arachnidlabs/minimatrix/schematics/minimatrix-render-front.png

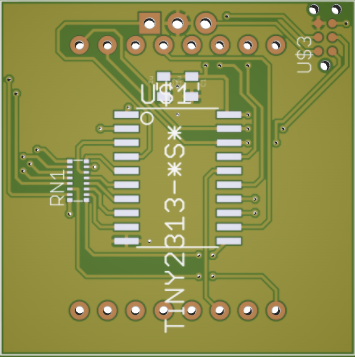
schematics/minimatrix-render-front.png
