arachnidlabs/minimatrix/schematics/minimatrix-render-back.png

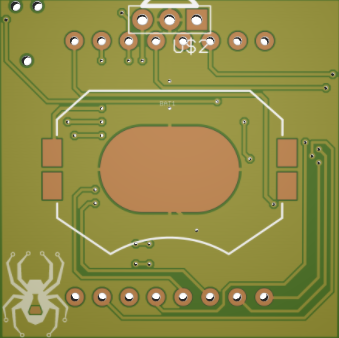
schematics/minimatrix-render-back.png
