arachnidlabs/minimatrix/README.Markdown

# Minimatrix

Minimatrix is a teeny little backpack for 3cm monocolor LED matrixes. It plays animations, and is reprogrammable via your computer monitor!
