arachnidlabs/minimatrix/schematics/minimatrix-layout.png

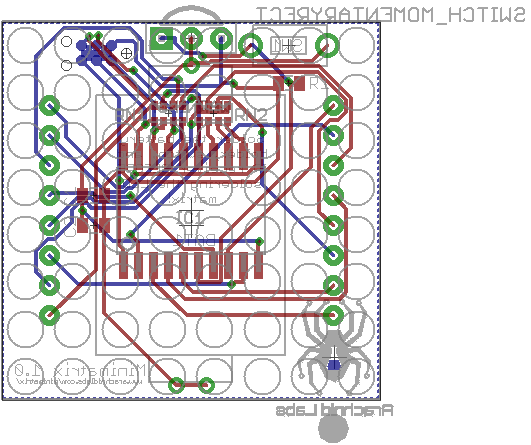
schematics/minimatrix-layout.png
