arachnidlabs/minimatrix/schematics/minimatrix-schematic.png

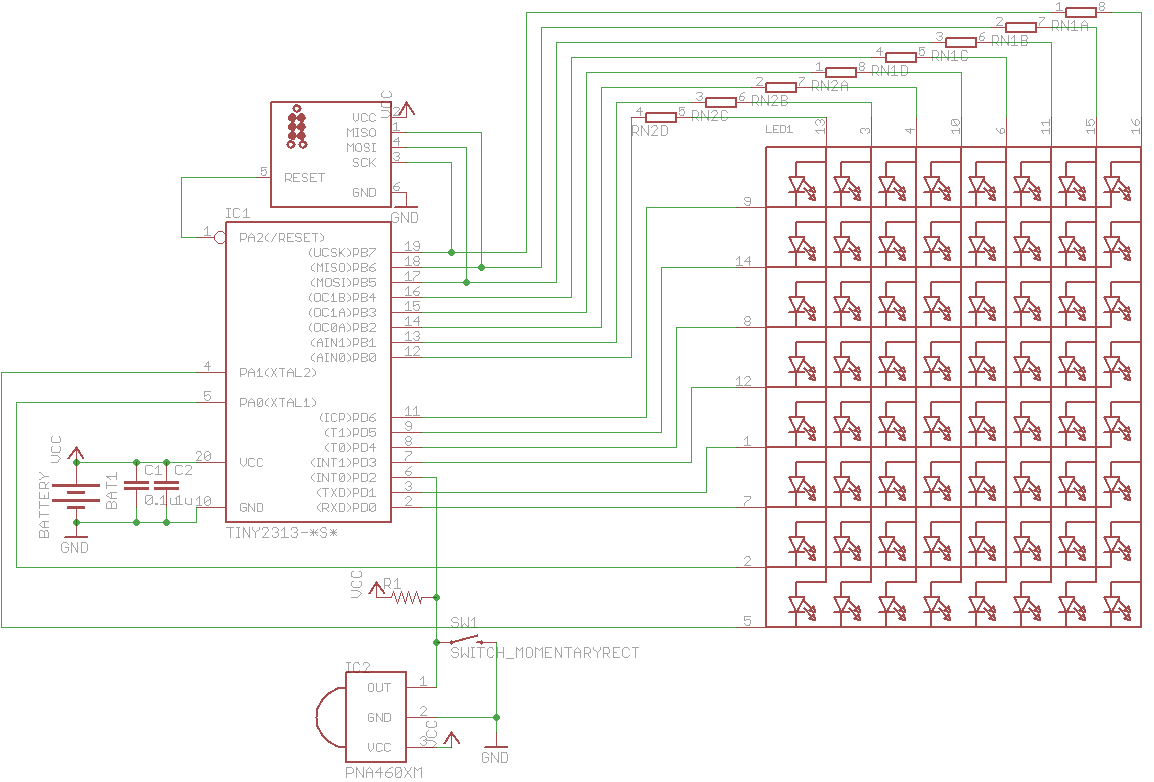
schematics/minimatrix-schematic.png
