arachnidlabs/minimatrix/schematics/pogojig-main.dxf

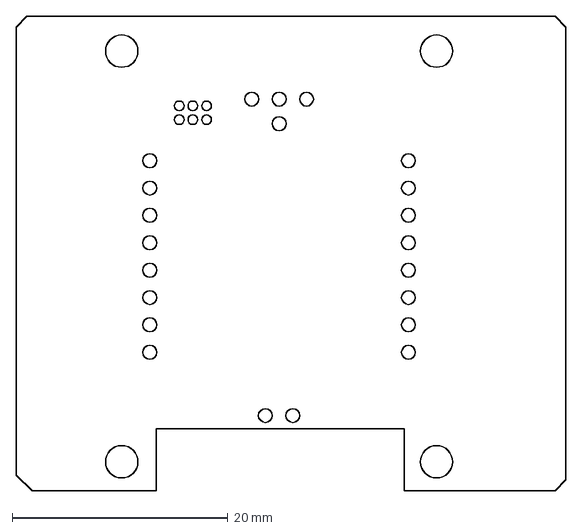
[picture p5: CAD file, 2013-07-08]
schematics/pogojig-main.dxf
51.0 x 44.0 mm
