arachnidlabs/minimatrix/schematics/pogojig.dxf

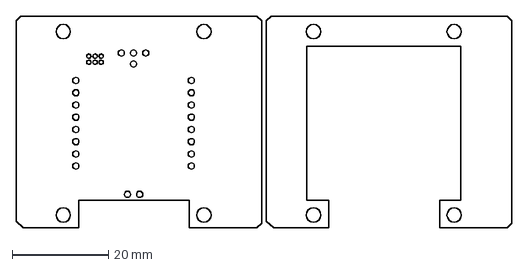
[picture p6: CAD file, 2013-07-08]
schematics/pogojig.dxf
103.0 x 44.0 mm
