arachnidlabs/minimatrix/(list of files, drawings)

Other design files:
schematics/pogojig.dsn
