arachnidlabs/minimatrix/schematics/pogojig.brd

## EAGLE design schematics/pogojig.brd (2013-07-08)

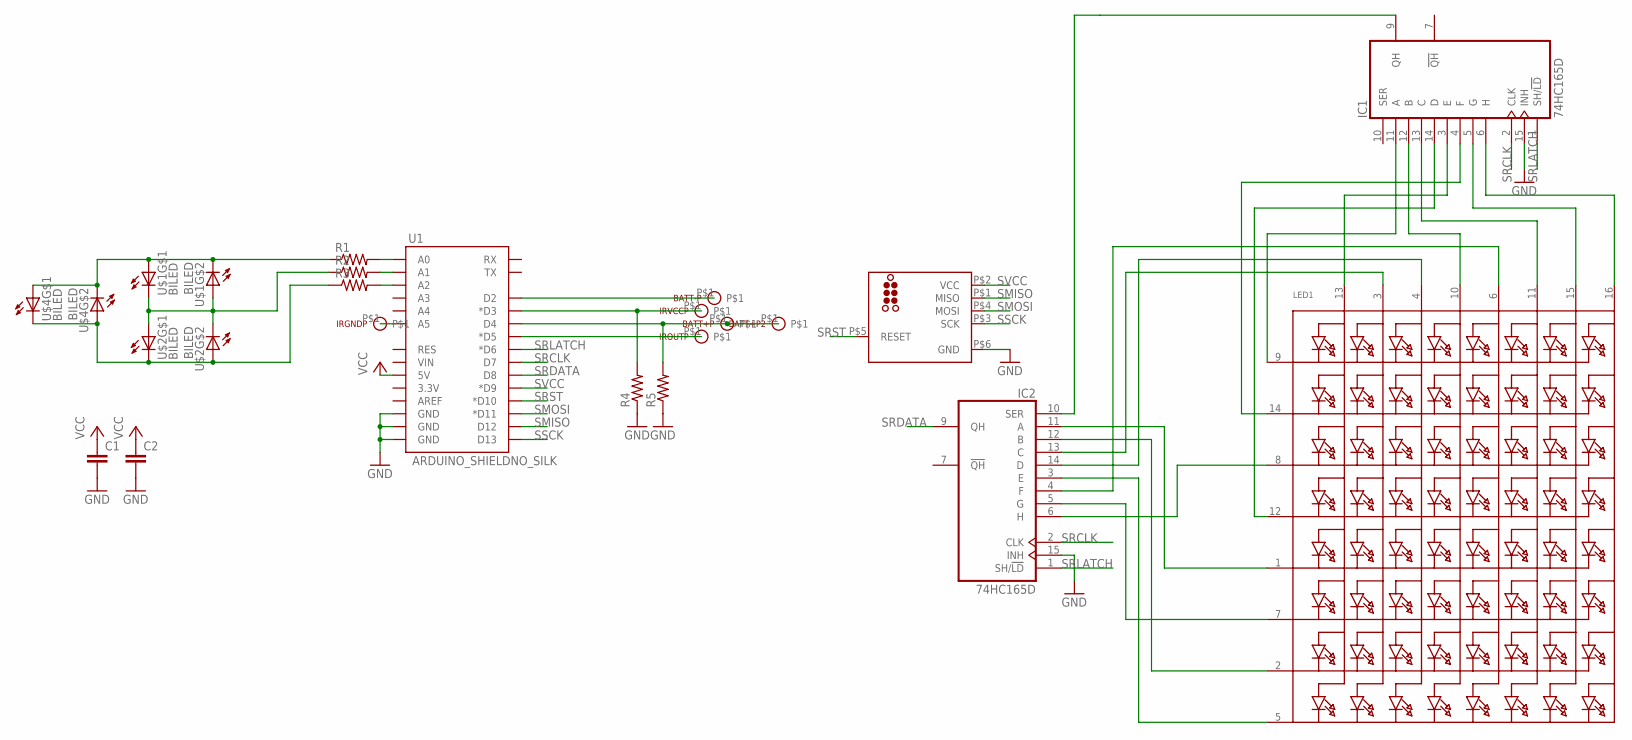
[picture p7: schematic pogojig.sch]

Parts:
BATT+P, BATT+P2: POGOPIN1.02; POGOPIN-1.02
BATT-P: POGOPIN1.02; POGOPIN-1.02
C1, C2: CAP0805; 0805
IC1, IC2: 74HC165D; SO16
IRGNDP: POGOPIN1.02; POGOPIN-1.02
IROUTP: POGOPIN1.02; POGOPIN-1.02
IRVCCP: POGOPIN1.02; POGOPIN-1.02
LED1: SEGMENT_8X8_ROWCATHODE; SEGMENT-30MM-POGO
R1, R2, R3, R4, R5: RESISTOR0805-RES; 0805
U1: ARDUINO_SHIELDNO_SILK; DUEMILANOVE_VIAS
U$1, U$2, U$4: BILED
U$3: TC2030_AVR; TC2030-MCP-NL-POGO

Connections:
GND: C1.2, C2.2, IC1.8 (GND), IC1.15 (INH), IC2.8 (GND), IC2.15 (INH), R4.1, R5.1, U1.GND@0 (GND), U1.GND@1 (GND), U1.GND@2 (GND), U$3.P$6 (GND)
unnamed: IC2.11 (A), LED1.1 (K5)
unnamed: IC2.12 (B), LED1.2 (K7)
unnamed: IC2.13 (C), LED1.3 (A2)
unnamed: IC2.14 (D), LED1.4 (A3)
unnamed: IC2.3 (E), LED1.5 (K8)
unnamed: IC2.4 (F), LED1.6 (A5)
unnamed: IC1.14 (D), LED1.12 (K4)
unnamed: IC2.5 (G), LED1.7 (K6)
unnamed: IC2.6 (H), LED1.8 (K3)
unnamed: IC1.11 (A), LED1.9 (K1)
unnamed: IC1.12 (B), LED1.10 (A4)
unnamed: IC1.13 (C), LED1.11 (A6)
unnamed: IC1.3 (E), LED1.13 (A1)
unnamed: IC1.4 (F), LED1.14 (K2)
unnamed: IC1.5 (G), LED1.15 (A7)
unnamed: IC1.6 (H), LED1.16 (A8)
unnamed: IC1.9 (QH), IC2.10 (SER)
unnamed: IRGNDP.P$1, U1.A5
unnamed: BATT+P.P$1, BATT+P2.P$1, R5.2, U1.D4
unnamed: BATT-P.P$1, U1.D2
unnamed: IRVCCP.P$1, R4.2, U1.D3 (*D3)
unnamed: IROUTP.P$1, U1.D5 (*D5)
unnamed: R3.2, U1.A2
unnamed: R2.2, U1.A1
unnamed: R1.2, U1.A0
unnamed: R3.1, U$2.A2 (A), U$2.C1 (C), U$4.A2 (A), U$4.C1 (C)
unnamed: R1.1, U$1.A1 (A), U$1.C2 (C), U$4.A1 (A), U$4.C2 (C)
unnamed: R2.1, U$1.A2 (A), U$1.C1 (C), U$2.A1 (A), U$2.C2 (C)
SMISO: U1.D12, U$3.P$1 (MISO)
SMOSI: U1.D11 (*D11), U$3.P$4 (MOSI)
SRCLK: IC1.2 (CLK), IC2.2 (CLK), U1.D7
SRDATA: IC2.9 (QH), U1.D8
SRLATCH: IC1.1 (SH/!LD), IC2.1 (SH/!LD), U1.D6 (*D6)
SRST: U1.D10 (*D10), U$3.P$5 (RESET)
SSCK: U1.D13, U$3.P$3 (SCK)
SVCC: U1.D9 (*D9), U$3.P$2 (VCC)
VCC: C1.1, C2.1, IC1.16 (VCC), IC2.16 (VCC), U1.5V

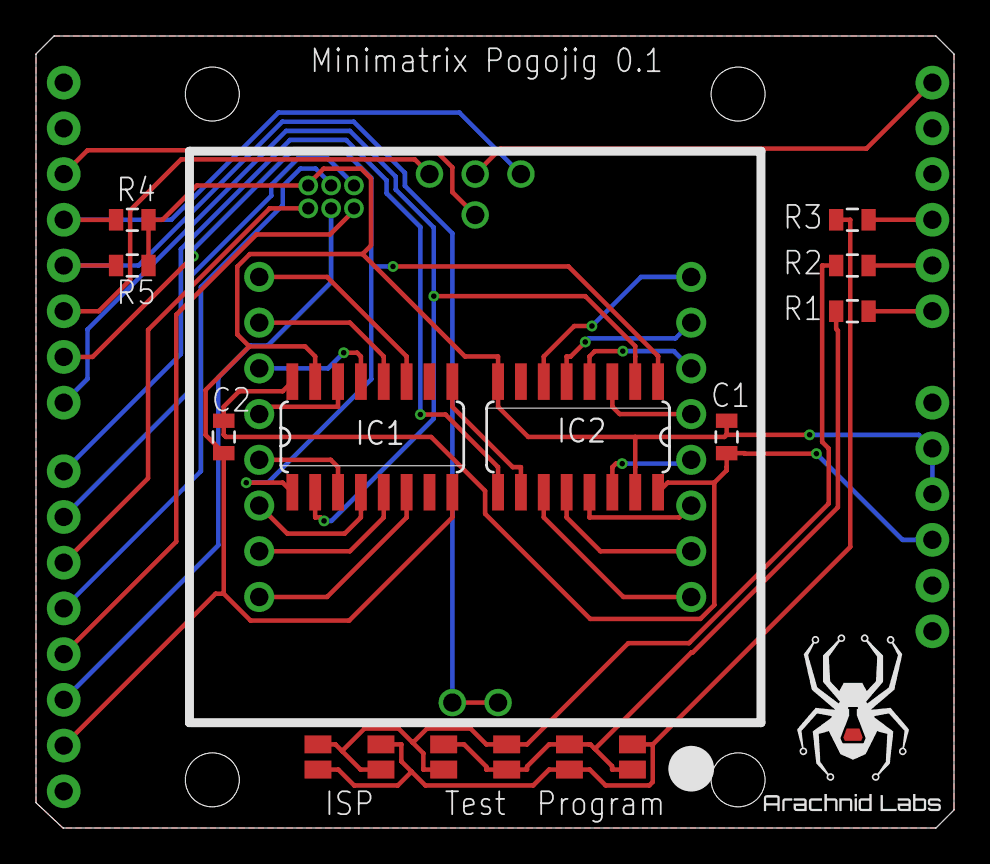
[picture p8: board pogojig.brd from above]

Board: 2 copper layers, 51.0 x 44.0 mm, 22 parts (1 on the bottom side), 38 nets.

Other parts of the board:
U$5: ARACHNID_LABS_LOGO_SM
