arachnidlabs/minimatrix/schematics/minimatrix.brd

## EAGLE design schematics/minimatrix.brd (2013-07-07)

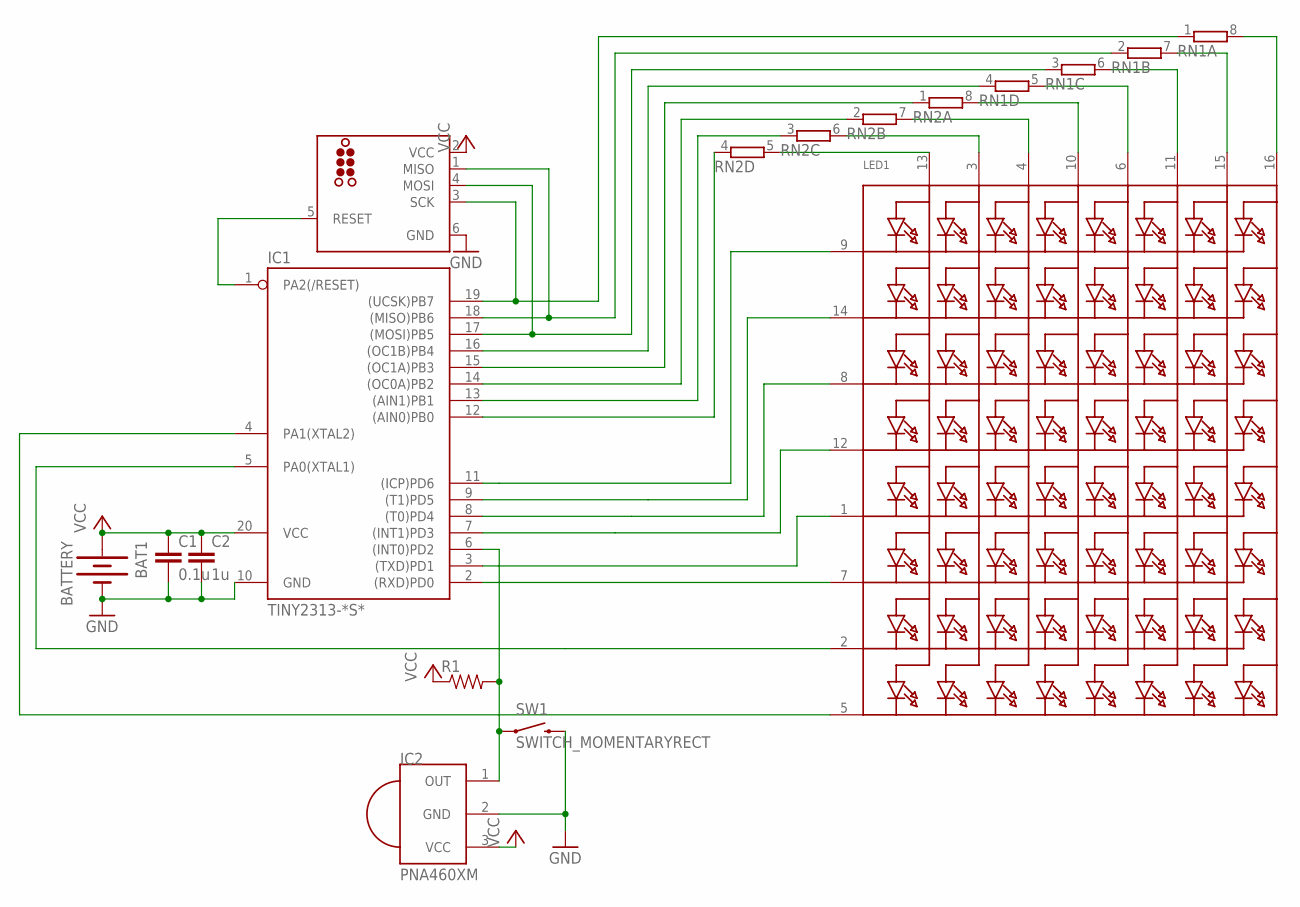
[picture p9: schematic minimatrix.sch]

Parts:
BAT1: BATTERY; COINCELL_PTH
C1: 0.1u; 0805
C2: 1u; 0805
IC1: TINY2313-*S*; SO20L$
IC2: PNA460XM
LED1: SEGMENT_8X8_ROWCATHODEM12A881UR; SEGMENT_BL-M12A881UR
R1: RESISTOR0805-RES; 0805
RN1, RN2: 4R-NCAY16; CAY16
SW1: SWITCH_MOMENTARYRECT; SWITCH_MOMENTARY_RECT
U$3: TC2030_AVRMCP-NL; TC2030-MCP-NL

Connections:
C2: IC1.13 ((AIN1)PB1), RN2.3 (1)
C3: IC1.14 ((OC0A)PB2), RN2.2 (1)
C4: IC1.15 ((OC1A)PB3), RN2.1
C5: IC1.16 ((OC1B)PB4), RN1.4 (1)
COL1: IC1.12 ((AIN0)PB0), RN2.4 (1)
GND: BAT1.NEG (-), C1.2, C2.2, IC1.10 (GND), IC2.2 (GND), SW1.P$2 (2), U$3.6 (GND)
MISO: IC1.18 ((MISO)PB6), RN1.2 (1), U$3.1 (MISO)
MOSI: IC1.17 ((MOSI)PB5), RN1.3 (1), U$3.4 (MOSI)
unnamed: IC1.2 ((RXD)PD0), LED1.7 (K6)
unnamed: LED1.3 (A2), RN2.6 (2)
unnamed: LED1.4 (A3), RN2.7 (2)
unnamed: LED1.10 (A4), RN2.8 (2)
unnamed: LED1.6 (A5), RN1.5 (2)
unnamed: LED1.11 (A6), RN1.6 (2)
unnamed: LED1.15 (A7), RN1.7 (2)
unnamed: LED1.16 (A8), RN1.8 (2)
unnamed: LED1.13 (A1), RN2.5 (2)
unnamed: IC1.3 ((TXD)PD1), LED1.1 (K5)
unnamed: IC1.4 (PA1(XTAL2)), LED1.5 (K8)
unnamed: IC1.6 ((INT0)PD2), IC2.1 (OUT), R1.2, SW1.P$1 (1)
R2: IC1.9 ((T1)PD5), LED1.14 (K2)
R3: IC1.8 ((T0)PD4), LED1.8 (K3)
R4: IC1.7 ((INT1)PD3), LED1.12 (K4)
R7: IC1.5 (PA0(XTAL1)), LED1.2 (K7)
RESET: IC1.1 (PA2(/RESET)), U$3.5 (RESET)
ROW1: IC1.11 ((ICP)PD6), LED1.9 (K1)
SCK: IC1.19 ((UCSK)PB7), RN1.1, U$3.3 (SCK)
VCC: BAT1.POS1 (+), BAT1.POS2 (+), C1.1, C2.1, IC1.20 (VCC), IC2.3 (VCC), R1.1, U$3.2 (VCC)

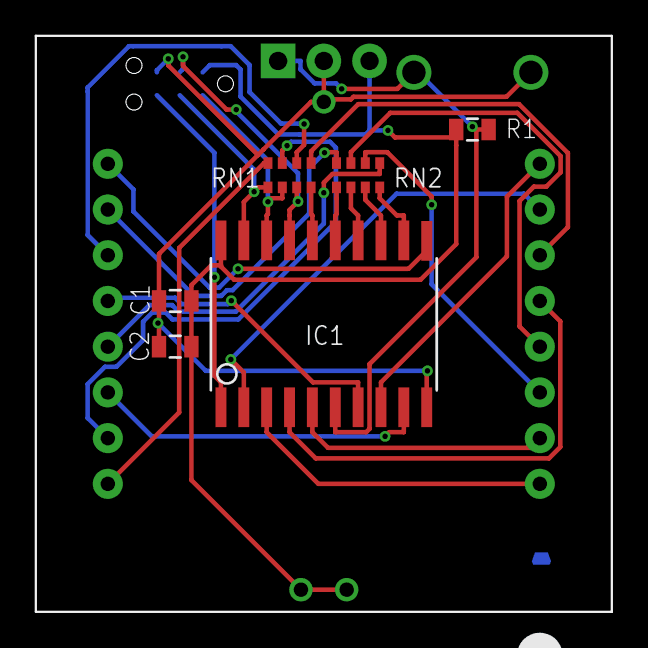
[picture p10: board minimatrix.brd from above]

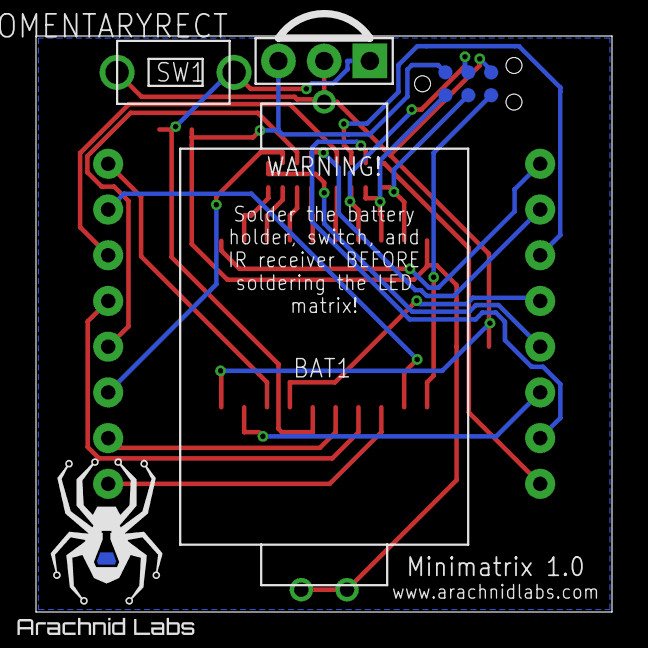
[picture p11: board minimatrix.brd from below]

Board: 2 copper layers, 32.0 x 32.0 mm, 12 parts (5 on the bottom side), 28 nets.

Other parts of the board:
U$4: ARACHNID_LABS_LOGO_SM
