arachnidlabs/minimatrix/firmware/src/hardware.h

#define COLUMN_PORT PORTB
#define COLUMN_DDR DDRB
#define PORTD_ROWS (_BV(PD6) | _BV(PD5) | _BV(PD4) | _BV(PD3) | _BV(PD1) | _BV(PD0))
#define PORTA_ROWS (_BV(PA1) | _BV(PA0))
#define IR_PIN PD2
