arachnidlabs/minimatrix/firmware/src/glcdfont.c

#include <avr/io.h>
#include <avr/pgmspace.h> 

#include "glcdfont.h"
 
// standard ascii 5x7 font

unsigned const char font[] PROGMEM = {
     0x7C,  0x54,  0x6C,  0x54,  0x7C,  
     0x7C,  0xDA,  0xF2,  0xDA,  0x7C,  
     0x7C,  0xD6,  0xF2,  0xD6,  0x7C,  
     0x38,  0x7C,  0x3E,  0x7C,  0x38,  
     0x18,  0x3C,  0x7E,  0x3C,  0x18,  
     0x38,  0xEA,  0xBE,  0xEA,  0x38,  
     0x38,  0x7A,  0xFE,  0x7A,  0x38,  
     0x00,  0x18,  0x3C,  0x18,  0x00,  
     0xFF,  0xE7,  0xC3,  0xE7,  0xFF,  
     0x00,  0x18,  0x24,  0x18,  0x00,  
     0xFF,  0xE7,  0xDB,  0xE7,  0xFF,  
     0x0C,  0x12,  0x5C,  0x60,  0x70,  
     0x64,  0x94,  0x9E,  0x94,  0x64,  
     0x02,  0xFE,  0xA0,  0xA0,  0xE0,  
     0x02,  0xFE,  0xA0,  0xA4,  0xFC,  
     0x5A,  0x3C,  0xE7,  0x3C,  0x5A,  
     0xFE,  0x7C,  0x38,  0x38,  0x10,  
     0x10,  0x38,  0x38,  0x7C,  0xFE,  
     0x28,  0x44,  0xFE,  0x44,  0x28,  
     0xFA,  0xFA,  0x00,  0xFA,  0xFA,  
     0x60,  0x90,  0xFE,  0x80,  0xFE,  
     0x00,  0x66,  0x91,  0xA9,  0x56,  
     0x06,  0x06,  0x06,  0x06,  0x06,  
     0x29,  0x45,  0xFF,  0x45,  0x29,  
     0x10,  0x20,  0x7E,  0x20,  0x10,  
     0x08,  0x04,  0x7E,  0x04,  0x08,  
     0x10,  0x10,  0x54,  0x38,  0x10,  
     0x10,  0x38,  0x54,  0x10,  0x10,  
     0x78,  0x08,  0x08,  0x08,  0x08,  
     0x30,  0x78,  0x30,  0x78,  0x30,  
     0x0C,  0x1C,  0x7C,  0x1C,  0x0C,  
     0x60,  0x70,  0x7C,  0x70,  0x60,  
     0x00,  0x00,  0x00,  0x00,  0x00,  
     0x00,  0x00,  0xFA,  0x00,  0x00,  
     0x00,  0xE0,  0x00,  0xE0,  0x00,  
     0x28,  0xFE,  0x28,  0xFE,  0x28,  
     0x24,  0x54,  0xFE,  0x54,  0x48,  
     0xC4,  0xC8,  0x10,  0x26,  0x46,  
     0x6C,  0x92,  0x6A,  0x04,  0x0A,  
     0x00,  0x10,  0xE0,  0xC0,  0x00,  
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
};
