arachnidlabs/minimatrix/tools/matrixJig/support.cpp

// Useful message printing definitions
#include "optiLoader.h"
/*
 * Low level support functions
 */

/*
 * flashprint
 * print a text string direct from flash memory to Serial
 */
void flashprint (const char p[])
{
    byte c;
    while (0 != (c = pgm_read_byte(p++))) {
	Serial.write(c);
    }
}

/*
 * hexton
 * Turn a Hex digit (0..9, A..F) into the equivalent binary value (0-16)
 */
byte hexton (byte h)
{
  if (h >= '0' && h <= '9')
    return(h - '0');
  if (h >= 'A' && h <= 'F')
    return((h - 'A') + 10);
//  error("Bad hex digit!");
}

/*
 * pulse
 * turn a pin on and off a few times; indicates life via LED
 */
#define PTIME 30
void pulse (int pin1, int pin2, int pinoff, int times) {
  pinMode(pin1, OUTPUT);
  pinMode(pin2, OUTPUT);
  pinMode(pinoff, INPUT);
  digitalWrite(pin1, LOW);
  digitalWrite(pinoff, LOW);
  do {
    digitalWrite(pin2, HIGH);
    delay(PTIME);
    digitalWrite(pin2, LOW);
    delay(PTIME);
  } 
  while (times--);
  pinMode(pin1, INPUT);
  pinMode(pin2, INPUT);
}

void led_on(int pin1, int pin2, int pinoff) {
  pinMode(pin1, OUTPUT);
  pinMode(pin2, OUTPUT);
  pinMode(pinoff, INPUT);
  digitalWrite(pin1, LOW);
  digitalWrite(pin2, HIGH);
  digitalWrite(pinoff, LOW);
}

void leds_off(int pin1, int pin2, int pin3) {
  digitalWrite(pin1, LOW);
  digitalWrite(pin2, LOW);
  digitalWrite(pin3, LOW);
  pinMode(pin1, INPUT);
  pinMode(pin2, INPUT);
  pinMode(pin3, INPUT);
}
