arachnidlabs/minimatrix/tools/matrixJig/images.cpp

#include <avr/pgmspace.h>
#include "optiLoader.h"
#include "main_data.h"
#include "test_data.h"

image_t PROGMEM image_main_bin = {
    {"minimatrix.hex"},
    {"attiny4313"},
    0x920d,				/* Signature bytes for 328P */
    {0x3F, 0xE4, 0xDF, 0xFF},            // pre program fuses (prot/lock, low, high, ext)
    {0x3F, 0xFF, 0xFF, 0xFF},           // fuse mask
    sizeof(main_bin),     // size of image in bytes
    sizeof(main_eebin),   // size of eeprom in bytes
    64,   // size in bytes of flash page
    4,    // size of eeprom page in bytes
    main_bin,
    main_eebin,
};

image_t PROGMEM image_test_bin = {
    {"test.hex"},
    {"attiny4313"},
    0x920d,				/* Signature bytes for 328P */
    {0x3F, 0xE4, 0xDF, 0xFF},            // pre program fuses (prot/lock, low, high, ext)
    {0x3F, 0xFF, 0xFF, 0xFF},           // fuse mask
    sizeof(test_bin),     // size of image in bytes
    0,
    64,   // size in bytes of flash page
    4, // size in bytes of eeprom page
    test_bin,
    NULL,
};

/*
 * Table of defined images
 */
image_t *images[] = {
  &image_main_bin,
  &image_test_bin,
};

uint8_t NUMIMAGES = sizeof(images)/sizeof(images[0]);
