arachnidlabs/minimatrix/(commit log)

2013-02-17 Initial commit.
    [minimatrix.brd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]
2013-02-17 Rearrange pins so the IR receiver is on an interrupt.
    [minimatrix.brd, minimatrix.sch]
2013-02-18 Rewire with fixed pinouts and better connection for IR receiver.
    [minimatrix.brd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]
2013-03-08 Reorganized repo; added initial firmware
    [minimatrix.brd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]
2013-03-10 Sense light levels and display them on LEDs
2013-03-14 Update design restoring IR receiver.
    [minimatrix.brd, minimatrix.sch]
2013-03-18 Changes for powerdown mode
2013-04-05 Tweaks for production version
    [minimatrix.brd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]
2013-07-01 Numerous changes and improvements
    [minimatrix.brd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]
2013-07-07 Work on programmer code; don't accept commands when asleep
    [minimatrix.brd, minimatrix.sch]
2013-07-08 Pogojig design files
    [pogojig-main.dxf, pogojig.brd, pogojig.dsn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]
2013-07-09 Fix programmer fuse writing by adding delays between fuses
    [code.cpp, matrixJig.ino]
2013-07-12 Fix eeprom write command
    [main.c]
2013-07-12 Preserve marquee position, and reset it when entering edit mode
    [main.c]
2013-08-31 Made the script executable, since otherwise it won't build.
    [imagebuilder.py]
2013-09-01 Use slower SPI
