arachnidlabs/minimatrix/(notices)

Notices in the files:
parts and their libraries:
nickparts: ©2009 ROFA.cz - modified and updated by Robert Darlington ‹rdarlington@gmail.com›
SparkFun-Boards: Licensing: CC v3.0 Share-Alike You are welcome to use this library for commercial purposes.
